i20091119-ai/2026memory/assets/heart.png

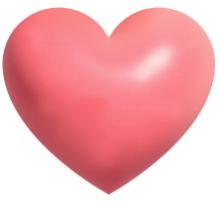
assets/heart.png
