i20091119-ai/2026memory/assets/mascot.png

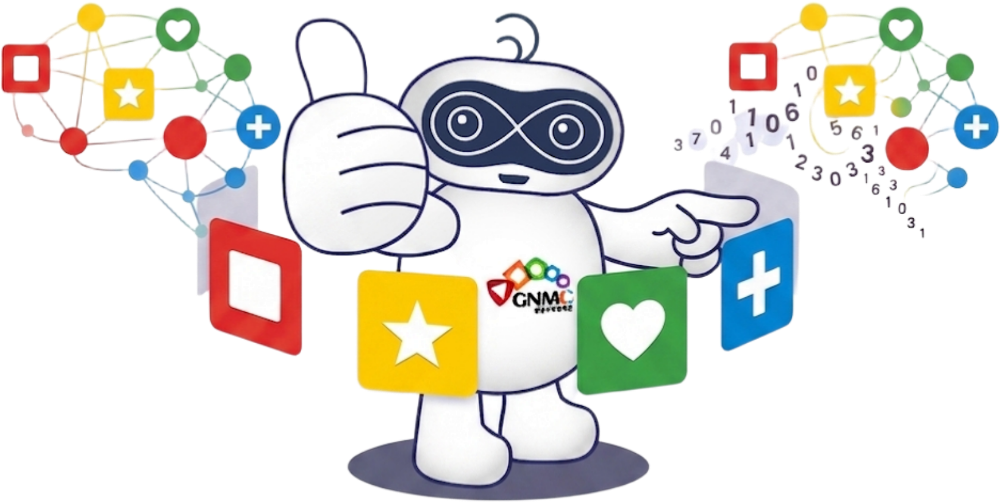
assets/mascot.png
