i20091119-ai/2026memory/README.md

# 토러스와 즐기는 랜덤 메모리 게임

100파이 아케이드 버튼 5개(빨강·노랑·초록·파랑 + 흰색)로 플레이하는 기억력 게임.
정식 게임기는 **라즈베리파이 5 한 대가 책상 2대(모니터 2대)**를 맡고, 두 사람이
흰색 버튼으로 서로 도전해 **2인 대결**을 할 수 있다.
**같은 코드가 일반 브라우저에서 키보드로도 그대로 플레이된다.**

시작할 때 **게임 종류를 버튼 색으로 고른다**:

```
빨강 = 색상  ·  노랑 = 숫자  ·  초록 = 모양  ·  파랑 = 혼합(셋이 섞여 랜덤)
```

한 게임은 **1개 기억 → 2개 → 3개 → 4개**의 4단계이고, **단계마다 5라운드**씩
반복한다 (총 20라운드 = 완주). 목숨은 3개 — 오답이 나오면 하나 줄고 같은
라운드를 **새로운 시퀀스**로 다시 낸다. 목숨이 0이 되면 게임 오버 —
초록 버튼으로 죽은 단계부터 이어하거나, 빨강 버튼으로 다른 게임을 고를 수 있다.

### 2인 대결 (흰색 버튼)

옆 책상에 사람이 있을 때 **흰색 버튼**을 누르면 그쪽 화면에 "도전에 응하시겠습니까?"가
10초 동안 뜬다. 상대가 **흰색을 누르면 수락**, 하던 걸 계속하면(다른 색 버튼을 누를 때마다
남은 시간이 2.5초씩 줄어든다) 그냥 지나간다. 도전은 놀고 있지 않을 때(타이틀·선택·
결과 화면)만 걸 수 있다.

수락하면 둘 다 하던 게임을 멈추고 대결로 들어간다:

- **게임 고르기** — 두 화면에 4색 카드. 먼저 누르는 사람이 정한다 (8초 지나면 혼합).
- **같은 문제가 동시에** 나온다. 먼저 전부 맞힌 사람이 1점. 틀리면 그 라운드는 상대 것,
  둘 다 틀리면 무효. 상대가 몇 개째 맞히는지 내 화면 위에 점으로 보인다.
- 1·1·2·2·3·3·4·4개 기억, 8라운드. **먼저 5점**을 따면 승리. 8라운드 뒤 동점이면 서든데스.
- 어느 쪽이든 빨강+파랑 2초 홀드로 대결을 끝낼 수 있다.

## 바로 해보기

**https://i20091119-ai.github.io/2026memory/** 에서 바로 할 수 있다.

직접 띄우려면:

```bash
python3 -m http.server 8000
# 브라우저에서 http://localhost:8000
```

키보드 **1 2 3 4 5** = 빨강·노랑·초록·파랑·흰색. 화면의 버튼·카드를 마우스나 터치로 직접 눌러도 된다.
`?seats=2` 를 붙이면 화면이 좌우 두 좌석으로 갈리고 오른쪽 좌석은 **Q W E R T** 다 (대결을 혼자 시험해 볼 수 있다).

> 빌드 단계가 없다. 저장소를 그대로 정적 서빙하면 끝이다.
> (파일을 직접 여는 `file://` 방식은 ES 모듈 제약 때문에 동작하지 않는다 — 위 명령을 쓸 것.)

## 조작

| | |
|---|---|
| 게임 고르기 | 선택 화면에서 **그 게임 색의 버튼**을 누른다 (카드가 버튼 색으로 칠해져 있다) |
| 색상 항목 회상 | 외운 색의 **버튼을 직접** 누른다 |
| 숫자·모양 항목 회상 | 4지선다 — 외운 값이 들어 있는 칸의 **색 버튼**을 누른다 |
| 혼합 게임 | 항목마다 위 두 방식이 자동으로 갈린다 |
| 화면 넘기기 | 게임 안내는 **아무 버튼이나 누를 때까지 기다린다** (자동으로 넘어가지 않는다) |
| 옆 사람에게 도전 | **흰색** 버튼 (타이틀·선택·결과 화면에서). 상대도 흰색을 누르면 대결 시작 |
| 홈으로 나가기 | **빨강 + 파랑을 2초 동안 함께** (화면 위쪽에 게이지가 찬다). 브라우저에서는 **ESC** 로도 된다 |
| 운영 기록 보기 | 타이틀에서 **노랑 + 초록을 3초 동안 함께**. 브라우저에서는 **0** 키 (아래 "운영 기록" 참조) |
| 입력 제한시간 | 없음 |

회상 중에는 화면 가운데 **답안 스트립**이 있어, 이번 단계가 몇 개짜리인지와
지금까지 무엇을 눌렀는지를 함께 보여 준다 (예: `4` `5` `7` `_` `_` — "5개 중 4번째").

틀렸을 때는 그 자리에 **내가 누른 값을 그대로** 넣고 빨간 테두리로 크게 흔든다.
정답을 대신 끼워 넣으면 "나는 이걸 눌렀는데 왜 다른 게 들어갔지?" 하는 오해가
생기기 때문이다. 정답이 무엇이었는지는 이어지는 오답 화면에서 따로 크게 보여 준다.

## 운영 기록 (부스 담당자용)

판마다 한 줄씩 **플레이 기록**이 남는다 — 시각, 게임 종류, 어디까지 갔나,
결과(완주/게임오버/중도이탈), 소요 시간, 이어하기·오답 횟수. 개인정보는 없고
기기의 localStorage 안에만 쌓이며 어디로도 보내지 않는다 (`js/playlog.js`).

타이틀에서 **노랑 + 초록을 3초** 누르면 집계 화면이 뜬다.

| 버튼 | |
|---|---|
| 노랑 | 기간 바꾸기 — 이번 달 → 지난 달 → 오늘 → 전체 |
| 초록 | 그 기간의 **CSV 저장** (다운로드 폴더, 엑셀에서 바로 열림) |
| 파랑 두 번 | 기록 전부 지우기 (실수 방지로 5초 안에 두 번) |
| 빨강 | 닫기 (90초 방치해도 닫힌다) |

보이는 것: 플레이 판 수 · 완주 수와 완주율 · 중도 이탈 · 한 판 소요 시간(중간값) ·
게임별 인기와 완주율 · **몇 개 기억까지 갔나**(탈락 곡선) · 시간대별 플레이.
"판"은 사람 수가 아니라 게임을 고른 횟수다 — 한 사람이 두 게임을 하면 2판이다.

키오스크에서 CSV 는 `~/Downloads/torus-log-2026-09.csv` 처럼 떨어지므로
SSH 나 USB 로 꺼내면 된다. 화면을 사진으로 찍어 가도 충분하게 만들어 두었다.

## 개발용 URL 옵션

| 옵션 | 효과 |
|---|---|
| `?game=4&level=3&round=2` | 해당 게임·단계·라운드에서 바로 시작 (1=색상 2=숫자 3=모양 4=혼합) |
| `?fast=1` | 연출 타이밍을 1/3로 단축 (반복 확인용) |
| `?cursor=1` | 마우스 커서를 되살린다 (기본은 키오스크용으로 숨김) |
| `?seats=2` | 두 좌석(책상 2대) 모드. 화면 가로세로비가 2.6 이상이면 저절로 켜진다 |
| `?debug=1` | `window.__torus` 로 좌석·대결 상태를 노출 (자동 검증용) |
| `?bridge=0` | "버튼 미연결" 경고를 끈다 (인코더 구성에서 브리지는 원래 없다) |

프로덕션 키오스크는 파라미터 없는 URL 로 뜨므로 자연히 비활성화된다.

## 테스트

게임 규칙(시퀀스 생성·4지선다 보기 생성·판정·상태 전이)은 `js/games.js` 에
**DOM 무의존 순수 함수**로 분리해 두었다. 그래서 별도 도구 없이 노드 내장 러너로 돌아간다.

```bash
node --test          # 72개 테스트 (게임 규칙 + 대결 규칙 + 모듈 정합성 + 플레이 기록 집계)
```

## 저장소 구조

게임 파일이 저장소 루트에 있다. GitHub Pages 를 루트로 배포하면 주소가 곧 게임이
되고, 하위 폴더 설정이나 리다이렉트가 필요 없다.

```
index.html              # 진입점
style.css
assets/                 # 그림 파일(PNG) — 덮어쓰면 코드 수정 없이 반영된다
├── background.png      #   전 화면 배경
├── mascot.png          #   타이틀 로봇
├── torus-*.png         #   안내 캐릭터 표정 4종
├── logo.png            #   기관 로고
├── favicon.png         #   탭 아이콘
└── heart*.png          #   목숨 하트 3종 (온전 / 깨짐 / 회색)
fonts/                  # 로컬 번들 웹폰트 (CDN 미사용)
js/
├── config.js           # 모든 튜닝 상수 (난이도·타이밍) — 조정은 여기서만
├── strings.js          # 모든 화면 문구 — 문구 수정은 여기서만
├── games.js            # 게임 규칙 순수 함수 (테스트 대상)
├── state.js            # 상태 머신 메인 루프 (좌석 하나의 혼자 놀기)
├── arena.js            # 두 좌석을 묶는 심판 — 도전 신청/수락, 대결 진행
├── versus.js           # 대결 규칙 순수 함수 (테스트 대상)
├── main.js             # 부트스트랩·좌석 생성·키오스크 설정
├── input.js            # KeyboardInput / GamepadInput(인코더) / SocketInput 추상화
├── audio.js            # Web Audio 효과음 합성 (외부 음원 없음)
├── logo.js             # 기관 로고 배치 (모든 화면 공통)
├── mascot.js           # 타이틀 로봇 캐릭터
├── torus.js            # 게임 중 안내 캐릭터 + 표정 4종
├── shapes.js           # 3차 도형 8종 SVG
├── storage.js          # 게임별 완주 횟수 저장/로드
├── playlog.js          # 플레이 기록(판마다 한 줄) + 집계·CSV — 운영자 화면의 재료
├── util.js             # DOM·대기 도우미 (중도 이탈 신호 포함)
└── scenes/             # title, select(게임 선택), intro, present, recall,
                        #   feedback, gameover, allclear, attract, admin(운영 기록),
                        #   versus(도전 프롬프트·대결 화면), hud, strip
firmware/button_bridge/ # 우노 Q 버튼 → WebSocket 브리지
├── sketch/sketch.ino   # STM32: 버튼 읽기 + 디바운스
└── python/main.py      # 리눅스: WebSocket 서버
scripts/                # 실물 게임기 설치용 (우노 Q 리눅스에서 실행)
├── survey.sh           # 부팅 시 켜지는 것 훑어보기 (읽기 전용)
├── disable-autostart.sh#   그중 하나만 끄기 / 되돌리기
├── install-kiosk.sh    # 게임 설치 + 자동시작 등록 (파이/우노 Q 자동 감지)
├── pi-kiosk.sh         # 라즈베리파이: 모니터 2대 배치·소리·3840×1080 창 띄우기
├── bridge-watch.sh     # (우노 Q) 버튼 브리지가 죽으면 진단·자동 복구
└── start-all.sh        # (우노 Q) 서버+브리지+전체화면 한 번에 띄우기
docs/assets.html        # 에셋 시트 (새로 그릴 그림 목록·규격)
docs/에셋시트.pdf        # 위 문서를 인쇄용으로 뽑은 것
docs/wiring.html        # 배선도 (조립용)
docs/배선도.pdf          # 위 문서를 인쇄용으로 뽑은 것
docs/hardware-guide.md  # 실물 조립·설치 가이드 (배선·전원·문제 해결)
docs/raspberry-pi-setup.md # 정식 게임기: 라즈베리파이 5 설치 절차
docs/buttontest.html    # 인코더 배선 확인 페이지 (누른 버튼에 불) — 파이에서 /docs/buttontest.html
docs/assembly.html      # 벤치 조립 가이드 (파이 단자·1차 연결·전체 연결·버튼/LED 배선 그림)
docs/조립가이드.pdf      # 위 문서 A4 가로 2장
docs/powerbutton.html   # 해설사용 전원 버튼 배선 (파이 5 J2)
docs/전원버튼배선.pdf    # 위 문서 A4 가로 1장
docs/labels.html        # 책상에 붙이는 버튼 안내 라벨 (흰 버튼=도전, 빨+파 2초=처음으로)
docs/버튼안내라벨.pdf    # 위 문서 A4 1장 (책상 2대분)
docs/desk.html          # 정식 게임기 책상 제작 도면 (치수·부재표·가공 체크리스트·겨냥도·배선도)
docs/책상도면.pdf        # 위 문서를 인쇄용으로 뽑은 것 (목공 사장님용)
docs/intro.html         # 한 장짜리 게임 소개 (실제 화면 캡처 docs/intro/*.png)
docs/게임소개.pdf        # 위 문서를 A4 가로 1장으로 뽑은 것
test/games.test.js      # node --test
```

설계명세서 §2 는 `web/` 하위에 두도록 되어 있으나, GitHub Pages 를 루트로 배포해도 바로 열리도록 저장소 루트로 옮겼다. 파일 구성 자체는 그대로다. 또 §2 목록에 더해 `shapes.js`(도형 SVG)와 `util.js`(공통 도우미),
`scenes/hud.js`·`scenes/attract.js` 를 두었다. 역할 분리를 위한 것으로 의존성은 늘지 않았다.

## 기술 스택

순수 HTML + CSS + ES 모듈 JavaScript. **빌드 도구·번들러·npm 의존성이 없다.**
외부 라이브러리도 CDN 링크도 쓰지 않아 오프라인 키오스크에서 완전히 동작한다.

- 렌더링: DOM + CSS 애니메이션, 필요한 곳만 인라인 SVG
- 저장: localStorage — 게임별 완주 횟수(`torus-memory.clears.v2`)와
  플레이 기록(`torus-memory.log.v1`, 최대 5,000줄). 하이스코어는 없다 —
  부스라 매번 다른 사람이 오고 게임에 끝이 있어 의미가 없다.
  접근이 막힌 환경에서도 게임은 정상 진행
- 사운드: Web Audio 합성 효과음만 (배경음악 없음, 음원 파일 없음)

### 폰트

두 벌을 `fonts/` 에 동봉해 쓴다. 둘 다 **SIL Open Font License 1.1** 이라 재배포가 허용된다.

| 쓰임 | 서체 | 파일 | 라이선스 |
|---|---|---|---|
| 제목·큰 글씨 | **Do Hyeon** (배민 도현체) | `DoHyeon-Regular.woff2` (200KB) | `OFL-DoHyeon.txt` |
| 말풍선·안내 문구 등 나머지 | **Jua** (주아체) | `Jua-Regular.woff2` (360KB) | `OFL-Jua.txt` |

출처: [google/fonts](https://github.com/google/fonts) — 원본 TTF 를 woff2 로 변환해 넣었다.

메이플스토리체처럼 둥글고 귀여운 느낌을 원했으나, 그 서체는 저장소 동봉(재배포)
조건을 확인할 수 없어 쓰지 않았다. 키오스크가 오프라인이라 폰트는 반드시 동봉해야
하므로, 재배포가 명확히 허용된 OFL 서체 중 가장 가까운 **주아체**를 골랐다.
바꾸려면 `fonts/` 에 woff2 를 넣고 `style.css` 의 `@font-face` 와 `--body` 만 고치면 된다.

## 그림 교체 (에셋)

새로 그릴 수 있는 그림의 목록·규격·주의사항은 **[`docs/에셋시트.pdf`](docs/에셋시트.pdf)** 에 정리해 두었다.
(원본은 `docs/assets.html` 이며, 브라우저로 열어 인쇄하면 PDF 가 다시 나온다 — 그림이
실제 게임 코드에서 렌더링되므로 항상 현재 상태와 일치한다.)

그림은 전부 `assets/` 의 **PNG 파일**이다. 같은 이름으로 덮어쓰면 코드 수정 없이 반영된다.
(도형 8종만 예외로 `js/shapes.js` 안에 SVG 로 들어 있고, 이건 확정이다.)

캐릭터·로고 크기는 px 로 고정하지 않고 **화면 높이에 맞춰** 정해진다
(`style.css` 의 `--char-h`, `--brand-h`). 낮은 화면에서도 서로 겹치지 않게 하기 위함이다.

## 실물 게임기

**정식 게임기(라즈베리파이 5 + USB 인코더, 책상 2대)** 설치는
[`docs/raspberry-pi-setup.md`](docs/raspberry-pi-setup.md) 를 따른다. 브리지·감시 스크립트 없이
`install-kiosk.sh` 한 번이면 된다. 책상(800×600×700 원목, 등판에 27" 모니터·스피커·제어부)
제작 도면은 **[`docs/책상도면.pdf`](docs/책상도면.pdf)** (원본 `docs/desk.html`).

파일럿 구성(우노 Q + App Lab 브리지)은 그대로 지원한다. 배선 그림은
**[`docs/배선도.pdf`](docs/배선도.pdf)**, 조립·키오스크 설정은
[`docs/hardware-guide.md`](docs/hardware-guide.md), 버튼 브리지는
[`firmware/README.md`](firmware/README.md) 참조.

우노 Q 리눅스에서 설치는 스크립트 세 줄이면 끝난다.

```bash
bash scripts/survey.sh morse          # 예전 앱이 어디에 걸려 있는지 (읽기만 함)
bash scripts/disable-autostart.sh …   # 그것만 끄기 (--restore 로 되돌림)
bash scripts/install-kiosk.sh         # 게임 설치 + 부팅 자동시작
```

웹앱은 시작할 때 `ws://localhost:8765` 접속을 시도하고, 실패하면 **조용히 키보드 모드로만
동작한다**(에러 화면이 뜨지 않는다). 접속 여부는 화면 **왼쪽 위 점**으로 표시된다 —
초록이면 연결됨, 회색이면 미연결. 실물 키오스크(localhost)에서 끊긴 동안에는
점이 빨갛게 바뀌고 **"버튼 미연결"** 글자까지 함께 뜬다.

부스 운영 중에 **게임은 멀쩡한데 아케이드 버튼만 조용히 죽는** 고장을 겪었다
(App Lab 의 브리지 앱이 멈춘 것이고, App Lab 은 멈춘 앱을 되살리지 않는다).
그래서 `install-kiosk.sh` 가 감시 서비스를 함께 등록한다 — 30초마다 8765 를
확인해서 닫혀 있으면 브리지를 다시 띄우고, 죽은 시각을
`~/torus-bridge-watch.log` 에 남긴다.

```bash
bash scripts/bridge-watch.sh --once      # 버튼이 안 먹을 때 한 줄 진단
bash scripts/bridge-watch.sh --restart   # 지금 당장 되살리기
```

## GitHub Pages 배포

저장소 **Settings → Pages** 에서

- Source: `Deploy from a branch`
- Branch: 배포할 브랜치 + 폴더 **`/`(root)**

로 지정하면 끝이다. 게임이 저장소 루트에 있으므로 주소가 곧 게임이 된다.

> 게임 파일을 하위 폴더(예전의 `web/`)에 두면, Pages 폴더 설정을 그 폴더로
> 정확히 맞추지 않는 한 루트에 `index.html` 이 없어 GitHub 이 `README.md` 를
> 대신 렌더링한다 — 게임 대신 이 문서가 뜬다. 그 함정을 없애려고 루트에 두었다.

빌드 단계가 없으므로 워크플로 설정은 필요 없다.
`.nojekyll` 은 Pages 가 파일을 Jekyll 로 가공하지 않고 그대로 서빙하게 한다.
