i20091119-ai/2026memory/docs/버튼안내라벨.pdf

## 버튼 안내 라벨 — 책상 2대분 (점선 따라 자르기)

코팅(라미네이팅)해서 양면테이프로 붙이거나, 투명 아크릴 명패에 끼운다. 도전 라벨은 흰 버튼 바로 옆 상판, 처음으로 라벨은 스커트 앞판 가운데(그릴 사이)에.

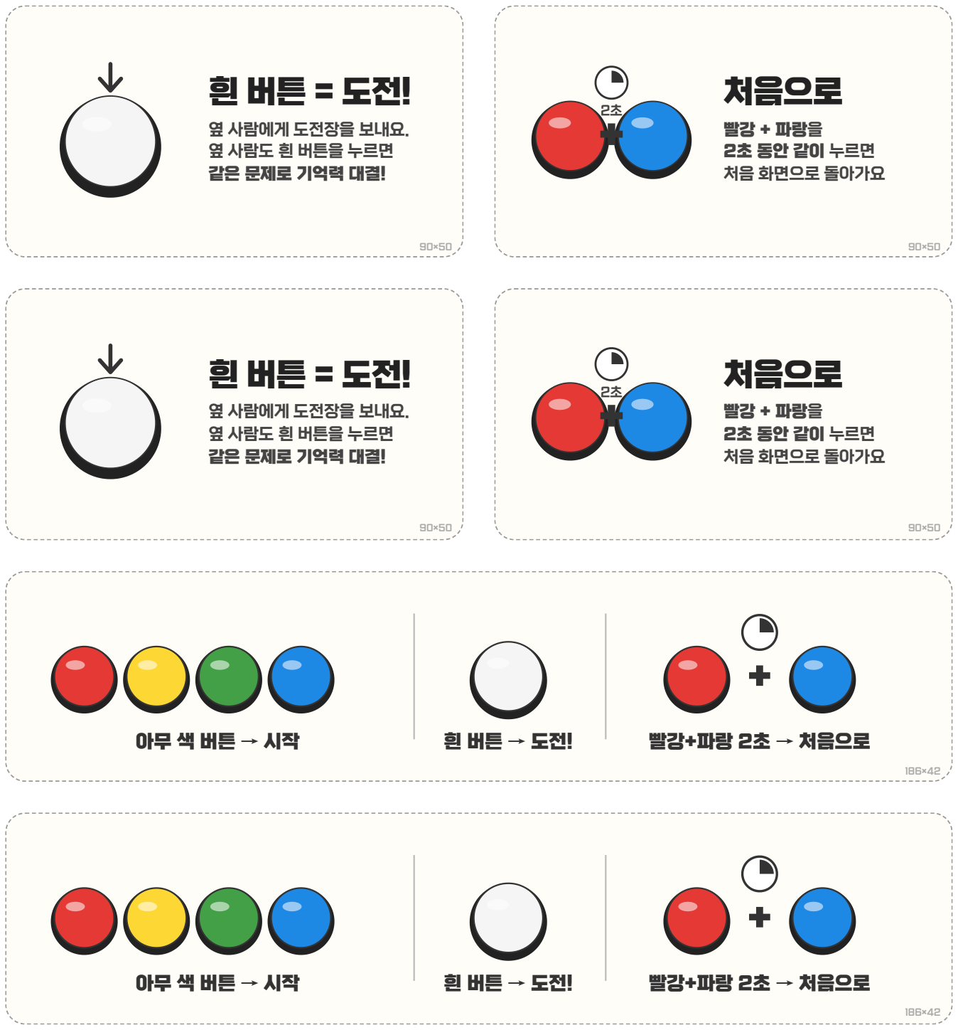
[picture p8: figure]
옆 사람에게 도전장을 보내요. 옆 사람도 흰 버튼을 누르면 같은 문제로 기억력 대결!; 처음으로; 빨강 + 파랑을 2초 동안 같이 누르면 처음 화면으로 돌아가요; 빨강+파랑 2초 → 처음으로

위치 제안 — ① "도전" 라벨: 흰 버튼 옆, 글자가 버튼을 가리키게. ② "처음으로" 라벨: 앞판 가운데 또는 빨강·파랑 사이 상판 앞쪽 가장자리. ③ 긴 라벨은 둘을 합친 것으로, 상판 앞 가장자리에 하나로 붙여도 된다 (그러면 ①②는 생략).
같은 내용이 게임 타이틀 화면 아래에도 그림으로 떠 있으니, 라벨은 화면을 안 볼 때를 위한 보조다.
