i20091119-ai/2026memory/assets/background.png

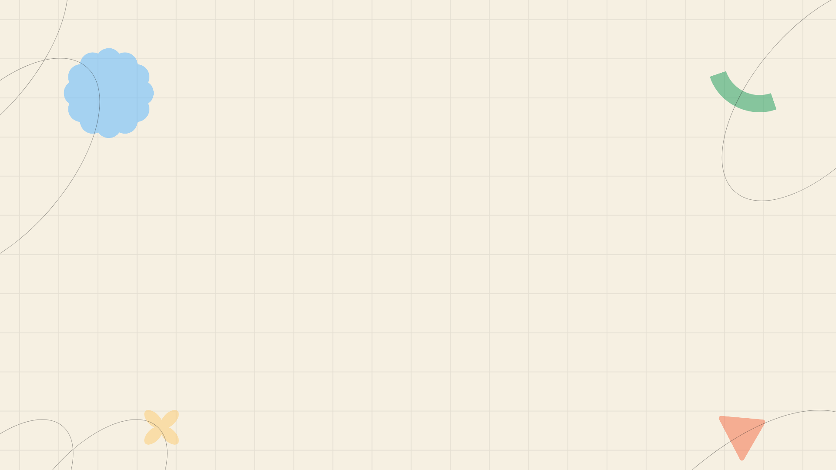
assets/background.png
