i20091119-ai/2026memory/assets/heart-broken.png

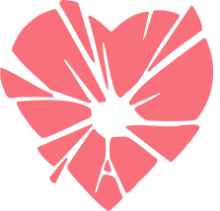
assets/heart-broken.png
