i20091119-ai/2026memory/assets/heart-off.png

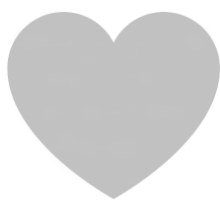
assets/heart-off.png
