i20091119-ai/2026memory/assets/torus-cheer.png

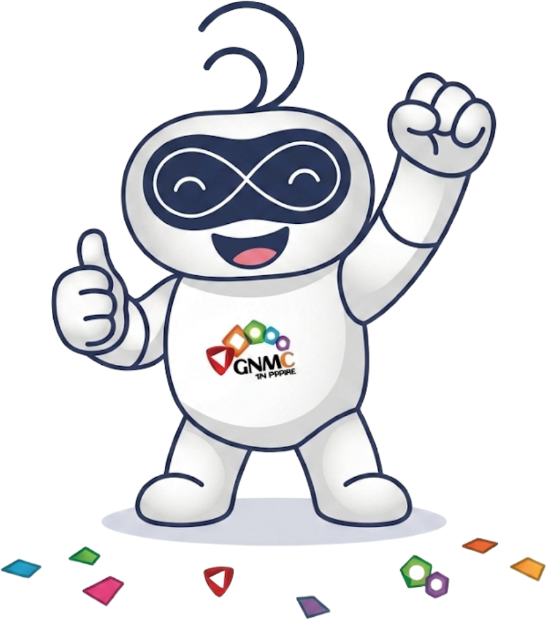
assets/torus-cheer.png
