i20091119-ai/2026memory/assets/torus-idle.png

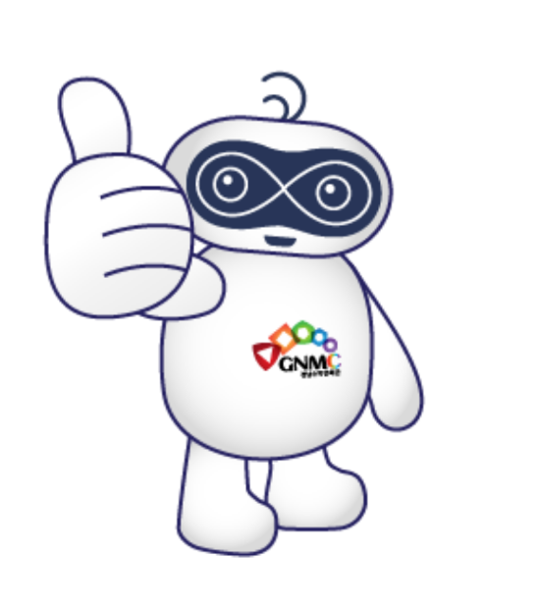
assets/torus-idle.png
