i20091119-ai/2026memory/assets/torus-sad.png

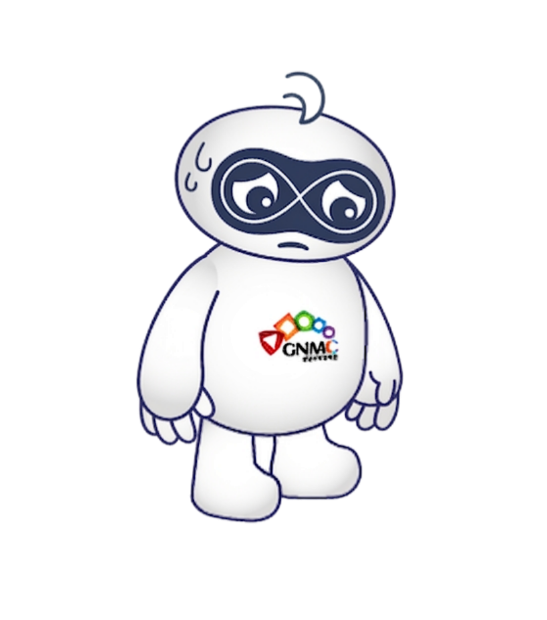
assets/torus-sad.png
