i20091119-ai/2026memory/assets/torus-talk.png

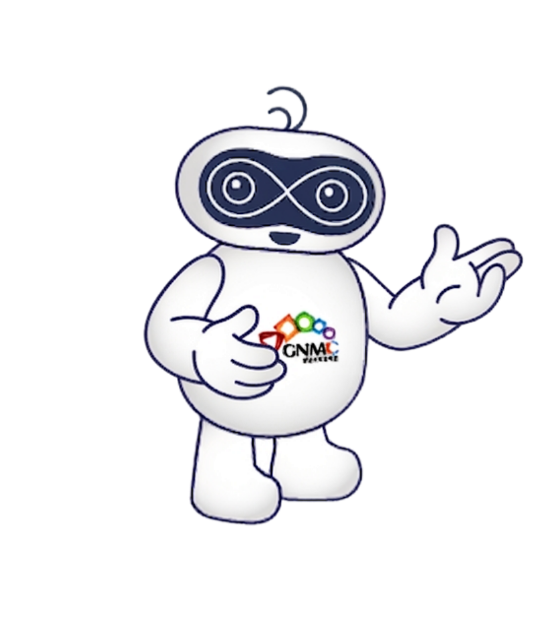
assets/torus-talk.png
