i20091119-ai/2026memory/docs/intro/allclear.png

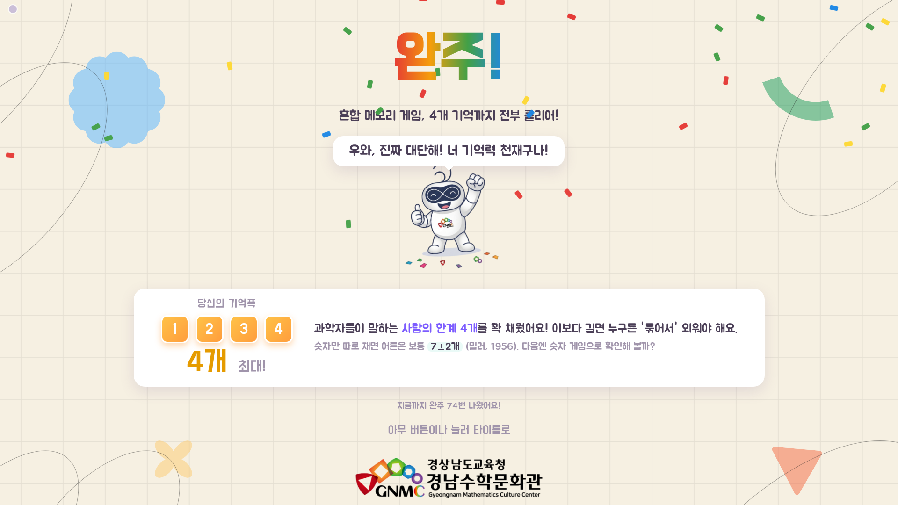
docs/intro/allclear.png
