i20091119-ai/2026memory/docs/intro/present.png

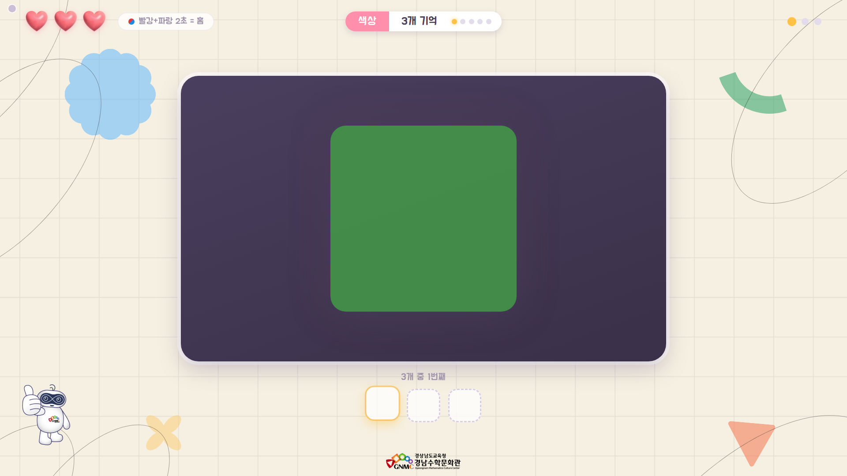
docs/intro/present.png
