i20091119-ai/2026memory/docs/intro/recall.png

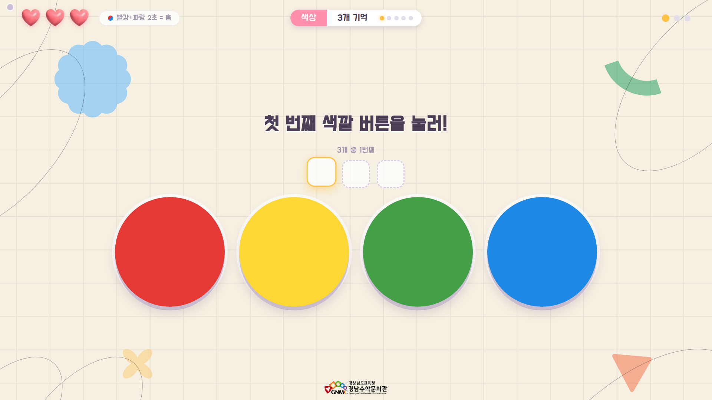
docs/intro/recall.png
