i20091119-ai/2026memory/docs/intro/select.png

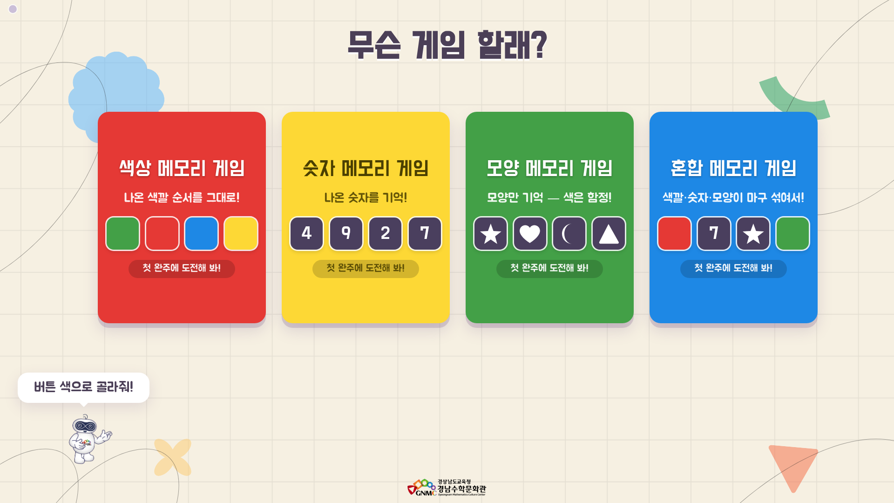
docs/intro/select.png
