i20091119-ai/2026memory/docs/intro/vs-challenge.png

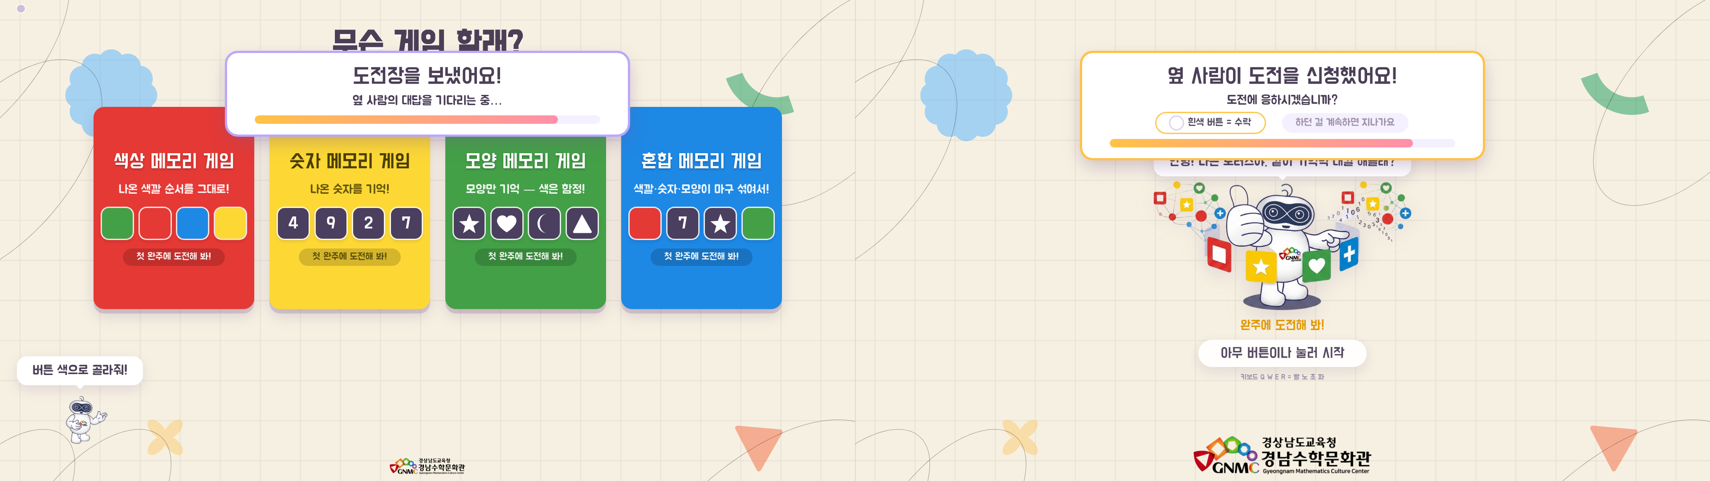
docs/intro/vs-challenge.png
