i20091119-ai/2026memory/(commit log)

2026-08-04 토러스와 즐기는 랜덤 메모리 게임 v1.1 구현
    설계명세서 v1.1 전체를 구현했다. 색깔(1차) → 숫자(2차) → 모양(3차)을
    차수당 5단계씩 자동 진행하는 코스형 기억력 게임으로, 4개의 아케이드 버튼
    또는 키보드 1·2·3·4 로 플레이한다.
    주요 구성
    - web/js/games.js: 시퀀스 생성·4지선다 보기 생성·판정·상태 전이를 DOM 무의존
    순수 함수로 분리. node --test 로 검증한다.
    - web/js/state.js: 명세서 §3.1 상태 머신 (목숨 3개 코스 공유, 오답 시 같은
    단계를 새 시퀀스로 재출제, 컨티뉴, 중도 이탈)
    - web/js/input.js: KeyboardInput / SocketInput 을 같은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
2026-08-04 Pages 를 저장소 루트로 배포해도 게임이 열리게 한다
    Pages 폴더를 /web 이 아닌 / 로 지정하면 루트에 index.html 이 없어
    GitHub 이 README.md 를 대신 렌더링한다 — 게임 대신 설명서가 뜬다.
    루트에 web/ 로 넘겨주는 리다이렉트 페이지를 두어 어느 폴더 설정에서도
    게임이 열리게 했다. 폴더를 /web 으로 지정하면 이 파일은 배포되지 않으므로
    영향이 없다. .nojekyll 로 Jekyll 가공 없이 그대로 서빙되게 했다.
    Claude-Session: https://claude.ai/code/session_01EKXYb7k7QXk6KPT26SBzSF
2026-08-04 게임을 저장소 루트로 옮겨 주소가 곧 게임이 되게 한다
    web/ 하위에 두면 Pages 폴더 설정을 /web 으로 정확히 맞추지 않는 한 루트에
    index.html 이 없어 GitHub 이 README.md 를 대신 렌더링한다. 리다이렉트로
    우회했지만 한 번 더 튕기는 것보다 애초에 루트에 두는 편이 낫다.
    web/ 의 내용을 저장소 루트로 옮기고 리다이렉트 페이지를 없앴다.
    테스트 임포트 경로, systemd 서빙 경로, 문서를 함께 맞췄다.
    파일 구성과 코드는 그대로이며 설계명세서 §2 대비 위치만 달라졌다.
    Claude-Session: https://claud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
2026-08-04 차수 안내를 버튼으로 넘기고, 답안 스트립과 화사한 테마를 넣는다
    - 차수 안내가 2.5초 만에 자동으로 지나가 규칙을 놓치는 문제. 이제 아무
    버튼이나 누를 때까지 기다린다. 직전 입력이 튀어 곧바로 넘어가지 않도록
    처음 INTRO_MIN_MS 동안은 입력을 무시하고, 그 뒤에 안내를 띄운다.
    - 홈으로 나가는 방법(빨강+파랑 2초)을 HUD 에 상시 표시하고, 홀드 게이지에
    "홈으로 돌아가는 중" 문구를 붙였다. 브라우저에서는 ESC 로도 나갈 수 있다.
    실기에는 ESC 가 없으므로 홀드 콤보가 여전히 정식 경로다.
    - 답안 스트립을 새로 만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
2026-08-04 타이틀 캐릭터를 로봇 마스코트로 바꾼다
    발주자가 준 캐릭터 시안(흰 몸통 + 남색 바이저 + 엄지척)을 인라인 SVG 로
    옮겨 타이틀 화면에 세웠다. 시안처럼 빨 네모·노 별·초 하트·파 십자 카드를
    부채꼴로 펼쳐 함께 배치했다.
    이미지 파일 대신 SVG 로 그린 이유: 오프라인 키오스크에서 해상도와 무관하게
    선명해야 하고, 저장소에 바이너리를 늘리지 않기 위해서다.
    게임 중 안내자(토러스)는 그대로 두었다 — 요청 범위가 메인 표지였다.
    Claude-Session: https://claude.ai/code/session_01EKXYb7k7QXk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
2026-08-04 차수 배지·기관 로고·에셋 시트를 넣는다
    - HUD 의 "1차 2단계"가 맨 글자라 밋밋했다. 두 칸짜리 배지(글상자)로 감싸고
    왼쪽 칸 색을 차수마다 다르게 했다 — 지금 어느 게임인지 색으로도 구분된다.
    - 기관 로고를 오버레이에 붙여 모든 화면에 항상 보이게 했다. 게임 중에는
    오른쪽 아래 작게, 타이틀·올클리어에서는 아래 가운데 크게 나온다.
    로고 크기 전환은 :has() 로 처리해 씬마다 코드를 넣지 않아도 된다.
    접속 상태 점은 로고 자리를 비켜 왼쪽 위로 옮겼다.
    assets/logo.svg 는 공식 로고 원본을 받기 전까지 쓰는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
2026-08-04 토러스 표정에서 celebrate 를 없애고 cheer 로 합친다
    cheer(단계 클리어)와 celebrate(올클리어)는 눈·입·팔·몸 애니메이션이 완전히
    같았고, 차이는 스프링클이 반짝이는 것뿐이었다. 표정이 아니라 장식 효과라
    따로 그릴 이유가 없다 — 그림을 새로 그릴 때 헛일이 된다.
    기쁜 표정은 cheer 하나로 합치고, 올클리어의 '더 요란한' 느낌은
    씬 선택자(.scene-allclear .torus)로 옮겼다. 화면상 결과는 그대로다.
    MOODS 를 export 해서 표정이 다시 늘어나지 않는지 테스트로 잡는다.
    에셋 시트도 표정 4종으로 갱신했다.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
2026-08-04 에셋 시트에 파일 이름 규칙을 추가한다
    새로 그린 그림을 넘겨받을 때 어느 파일이 어느 그림인지 헷갈리지 않도록,
    코드에서 쓰는 키와 같은 이름을 쓰기로 하고 표로 정리했다.
    도형 8개는 js/config.js 의 SHAPES 목록과 글자까지 같아야 하며, 어긋나면
    정합성 테스트가 잡아낸다.
    쪽이 늘어나 고정 쪽번호(N / 4)가 틀리게 되어 없앴다.
    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
2026-08-04 에셋 시트에서 도형 8종을 확정으로 표시한다
    도형은 지금 것으로 간다는 결정을 문서에 반영했다. 전체 목록에 '상태' 열을
    넣어 새로 그릴 것과 유지할 것을 구분하고, 파일 이름 표에서도 도형은
    넘길 파일이 없다고 못 박았다. 그리는 사람이 헛일하지 않게 하는 게 목적이다.
    규격 자체는 남겨 뒀다 — 나중에 바꿀 일이 생기면 그때 필요하다.
    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
2026-08-04 배경과 목숨 하트를 그림 파일로 빼고, 배경 디자인 요구서를 넣는다
    배경이 CSS 그라데이션이라 그림 파일을 받을 자리가 없었다. assets/background.svg
    한 장으로 옮기고 body 가 cover 로 깔도록 바꿨다 — 파일만 덮어쓰면 배경이 바뀐다.
    장식 방울도 CSS 가상요소에서 그림 안으로 옮겨, 배경은 이 파일 하나가 전부가 된다.
    하트도 글자(♥)라 서체에 따라 모양이 달라지고 그림으로 교체할 수 없었다.
    heart / heart-broken / heart-off 세 장으로 바꿔, 목숨을 잃는 순간에는 깨진 하트가
    잠깐 보였다가 회색으로 확정된다.
    에셋 시트에 배경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
2026-08-04 그림을 PNG 파일로 받을 수 있게 바꾼다
    캐릭터 두 개가 코드 안에 SVG 로 박혀 있어서 그린 PNG 를 넣을 자리가 없었다.
    mascot.js / torus.js 를 <img> 기반으로 바꾸고, 안내 캐릭터는 표정마다 그림
    한 장씩(4장)을 쓰게 했다. 로고·하트·배경도 PNG 로 통일했다.
    지금 있는 임시 그림을 그대로 PNG(투명 배경)로 뽑아 넣어 뒀으므로, 실제 그림이
    오면 같은 이름으로 덮어쓰기만 하면 된다.
    그림 경로는 import.meta.url 기준으로 풀었다. 문서(docs/assets.html)처럼 다른
    깊이의 페이지에서 모듈을 불러도 경로가 깨지지 않는다.
    에셋 시트를 PNG 기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
2026-08-04 올려준 그림 파일을 반영한다
    파일명 오타를 고쳤다: herat-broken.png → heart-broken.png. 그대로 두면 깨진
    하트만 임시 그림이 나온다.
    전부 1920×1080 캔버스에 그려져 있어 화면에서 캐릭터가 아주 작게 나왔다.
    코드가 가로폭 기준으로 크기를 맞추는데, 그림 대부분이 투명 여백이라
    캐릭터가 실제로는 1/3 크기로 그려진 탓이다. 투명 여백을 잘라내고 권장
    크기로 줄였다 — 그림 자체는 손대지 않았고 여백만 없앴다.
    표정 4종과 하트 3종은 각각 '공통 여백'으로 잘라, 전환할 때 캐릭터가
    튀지 않게 했다. 전체 용량은 3.7MB → 1.7MB.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
2026-08-04 화면 비율에 따라 잘리거나 겹치던 문제를 고친다
    캐릭터 크기를 px 로 고정해 두어서, 화면이 낮으면 내용이 세로로 넘쳐 위가
    잘리고 요소끼리 겹쳤다. 크기를 화면 높이(vh) 기준으로 바꾸고 씬마다 상한을
    따로 뒀다. JS 의 인라인 px 지정을 없애 CSS 가 크기를 온전히 맡는다.
    말풍선이 캐릭터에 가려지던 것을 고쳤다(z-index). 캐릭터가 손을 들면
    말풍선 위를 덮었다.
    로고를 오른쪽 아래에서 아래 가운데로 옮겼다. 배경 그림은 네 모서리에 장식이
    있고 아래 가운데가 비어 있어, 거기가 유일하게 깨끗한 자리다. 로고 높이를
    -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
2026-08-05 코드 주석의 그림 규격을 실제와 맞춘다
    mascot.js / torus.js 주석이 '정사각 800×800' 을 권장한다고 남아 있었다.
    실제로는 캐릭터에 맞게 잘라 주면 되고, 크기는 화면 높이에 맞춰 정해진다.
    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
2026-08-05 본문 서체를 주아체로 바꾸고 작은 요소들을 키운다
    말풍선을 비롯한 본문 글씨가 시스템 기본 서체라 딱딱했다. 둥글고 귀여운
    주아체(Jua)로 바꿨다. 제목은 그대로 도현체를 쓴다.
    메이플스토리체를 쓰지 않은 이유: 키오스크가 오프라인이라 폰트를 저장소에
    동봉해야 하는데 재배포 조건을 확인할 수 없었다. 재배포가 명확히 허용된
    OFL 서체 5종을 실제 문구로 비교해 가장 가까운 주아체를 골랐다.
    손글씨 계열(동글·개구·감자꽃·하이멜로디)은 작은 글씨에서 읽기 어려웠다.
    작아서 눈에 안 들어오던 것들을 키웠다 —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
2026-08-05 오답·목숨 연출을 눈에 보이게 고침
    하트 깨짐:
    - 그림 하트로 바꾼 뒤 연출이 700ms 스케일 변화뿐이라 알아보기 어려웠다.
    1500ms 3박자(쿵 → 흔들 → 툭)로 늘리고, 화면이 뜨는 것과 겹치지 않게
    220ms 뜸을 들인 뒤 시작한다.
    - 밝기 번쩍임은 크림색 배경에서 하얗게 날아가 오히려 안 보여서, 붉은
    빛무리(drop-shadow)로 대신했다.
    - 애니메이션이 끝나도 회색으로 되돌리지 않고 깨진 하트를 그대로 남긴다.
    오답 화면이 끝나고 HUD 가 새로 그려질 때 자연히 회색이 된다.
    - 연출이 다 들어가도록 MISS_MS 1200 → 2100.
    답안 스트립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
2026-08-05 카운트다운을 셋·둘·하나로 바꿔 문제와 구분되게 함
    2차(숫자)에서 3·2·1 을 흰색 아라비아 숫자로 크게 띄우니 외워야 할 숫자와
    생김새가 똑같아서, 이게 카운트인지 문제인지 헷갈린다는 지적이 있었다.
    네 가지를 한꺼번에 다르게 두어 겹칠 여지를 없앴다.
    - 글자: 아라비아 숫자 → 한글 (셋·둘·하나). 끝은 '준비!' 대신 '시작!'
    - 색 : 흰색 → 노란색 (외울 숫자는 흰색 그대로)
    - 모양: 남은 시간이 줄어드는 원형 게이지 링 안에 넣어 타이머로 보이게.
    링이 도는 시간은 COUNTDOWN_MS 를 그대로 받아 항상 한 칸에 한 바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
2026-08-05 우노 Q 설치 스크립트 추가 (기존 앱 정리 포함)
    보드에 올릴 때 손으로 systemd 유닛을 적어 넣던 절차를 스크립트로 만들었다.
    예전에 올린 다른 앱(모스부호)이 부팅과 함께 켜지고 있어서, 그것만 정확히
    떼어 내는 도구가 먼저 필요했다.
    scripts/survey.sh
    부팅 시 켜지는 것을 전부 훑어 보여 준다. 아무것도 고치지 않는다.
    systemd 시스템/사용자 서비스, .desktop 자동시작, crontab @reboot,
    rc.local·프로필, App Lab 앱 디렉터리, 화면 세션 상태까지 한 번에 본다.
    자동 실행 경로가 여러 갈래라, 어디에 걸렸는지 모르고 지우면 엉뚱한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
2026-08-05 조립용 배선도 추가
    지금까지 배선 정보가 hardware-guide.md 의 표로만 있어서, 함체 앞에서 실제로
    선을 물릴 때 참고하기 어려웠다. 인쇄해서 옆에 두고 볼 그림을 만들었다.
    docs/wiring.html → docs/배선도.pdf (A4 2장)
    1쪽 버튼 스위치 → 우노 Q (D2~D5 + GND 데이지체인), 배선표,
    마이크로스위치 COM/NO/NC 구분
    2쪽 LED 12V 병렬 회로, 전원·영상 계통, 신호 흐름, 조립 순서 체크리스트,
    배선 확인 절차, 증상별 점검표
    회로도 관례대로 점(●)이 찍힌 곳만 전기적 연결이고 그냥 교차하는 선은
    이어지지 않는다는 것을 두 그림 모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
2026-08-05 배선도를 실물 부품에 맞춰 보완
    실제 도착한 부품을 보고 문서와 다른 점을 고쳤다.
    - 스위치(BLEE)에 COM①·NC②·NO③ 이 각인되어 있다. 도통 확인 없이 글자만 보고
    물리면 되므로 조립 순서를 그렇게 바꿨다. 각인 없는 스위치를 쓸 경우의
    확인법은 남겨 두었다.
    - "스페이드 단자로 무납땜" 한 가지만 적어 두었던 것을 압착·납땜 두 방법으로
    넓혔다. 납땜은 3초 안에 끝내야 스위치 내부가 안 녹는다는 것,
    어느 쪽이든 수축튜브로 절연해야 NC② 에 닿지 않는다는 것을 명시했다.
    - LED 저항 필요 여부를 판단하는 절을 새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
2026-08-06 App Lab 앱 파일 추가 (실제 보드에서 확인한 형식)
    우노 Q 에 스케치를 올리려니 App Lab 이 firmware/button_bridge 를 앱으로
    인식하지 못했다. 같은 보드에서 돌던 앱의 형식을 확인해 그대로 맞췄다.
    - app.yaml — name/description/icon/version + ports(정수 리스트) + bricks
    - sketch/sketch.yaml — FQBN arduino:zephyr:unoq, 플랫폼 arduino:zephyr,
    Bridge RPC 용 라이브러리 4종. 지금 스케치는 시리얼 방식이라 안 쓰지만
    USE_BRIDGE 를 1 로 바꿀 때 필요하므로 남겨 둔다.
    브리지 바인드 주소를 --host / TORUS_BRIDGE_HOST 로 고를 수 있게 했다.
    App Lab 은 파이썬을 컨테이너에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
2026-08-06 브리지 입력 소스와 바인드 주소를 자동으로 고르게 함
    실물 우노 Q 에서 확인한 사실을 반영했다. 이 보드는 STM32 가 내장이라
    USB 시리얼(/dev/ttyACM*)로 잡히지 않는다 — 실제로 ttyS0~S3 만 있고
    그건 STM32 와 무관하다. 기본값이던 시리얼 방식은 이 보드에서 쓸 수 없다.
    같은 보드에서 돌던 앱을 보니 통신은 App Lab Bridge RPC 로만 이뤄지고 있었다.
    Bridge.provide(이름, 콜백) 으로 MCU 의 통지를 받는 구조로, 저장소의
    run_bridge() 가 이미 쓰고 있던 방식과 같다. 다만 arduino.app_utils 는
    App Lab 런타임 안에서만 임포트되므로, 브리지는 App Lab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
2026-08-06 스케치를 실물에서 확인한 Bridge API 로 맞춤
    같은 보드에서 돌던 앱의 스케치를 확인해 추측으로 적어 두었던 부분을 고쳤다.
    - 헤더가 <Bridge.h> 가 아니라 <Arduino_RouterBridge.h> 다. 플랫폼
    (arduino:zephyr)에 들어 있어 sketch.yaml 의 libraries 에는 안 적는다.
    - loop() 에 Bridge.update() 가 필요하다. 이게 빠지면 RPC 가 돌지 않는다.
    - USE_BRIDGE 기본값을 1 로 바꿨다. 우노 Q 는 STM32 가 내장이라 USB 시리얼로
    잡히지 않아 Bridge 말고는 통로가 없다. 시리얼 경로는 다른 보드용으로 남겼다.
    install-kiosk.sh 는 USB 시리얼 장치가 없으면 브리지 서비스를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
2026-08-06 버튼 이벤트를 로그에 남겨 배선 확인이 되게 함
    App Lab 로그만 보고는 브리지가 버튼을 받고 있는지 알 수 없었다. 설치 직후
    "왼쪽부터 눌러서 0→1→2→3 이 찍히는지" 확인하는 게 배선 검증의 핵심인데
    그걸 볼 방법이 없었다.
    처음 12번은 INFO 로 남기고 그 뒤로는 DEBUG 로 내린다. 설치 확인은 되면서
    상시 운영 중에 로그가 쌓이지는 않는다. -v 를 붙이면 계속 다 보인다.
    색 이름을 함께 찍어 배선이 뒤바뀐 경우를 바로 알아볼 수 있게 했다.
    Claude-Session: https://claude.ai/code/session_01EKXYb7k7Q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
2026-08-06 start-all.sh 도 브리지 중복 실행을 피하게 함
    우노 Q 에서는 브리지가 App Lab 앱으로 8765 를 이미 잡고 있다. 그 상태에서
    start-all.sh 가 브리지를 또 띄우면 포트가 충돌한다. install-kiosk.sh 에 넣은
    것과 같은 판단을 여기에도 넣었다.
    - 8765 가 이미 열려 있으면 그대로 두고 넘어간다
    - USB 시리얼 장치가 없으면 App Lab 으로 안내하고 건너뛴다
    - 있으면 찾은 장치 이름을 그대로 쓴다 (/dev/ttyACM0 고정을 없앴다)
    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
2026-08-06 키오스크가 부팅 시 안 뜨던 문제 수정
    재부팅했더니 웹서버·브리지는 뜨는데 크로미움만 안 떴다. 원인은 키오스크
    등록 방식을 고르는 판단이 틀렸던 것이다.
    graphical-session.target 은 어느 배포판에나 유닛 파일이 있어서, 파일 존재만
    확인하면 항상 "서비스로 걸 수 있다"고 판단해 버린다. 하지만 세션 관리자가
    systemd 와 연동되지 않으면(XFCE 등 흔하다) 부팅해도 그 타깃이 활성화되지
    않아 서비스가 영영 안 뜬다. 실제로 활성 상태인지를 보도록 고쳤다.
    같은 보드의 다른 앱이 .desktop 자동시작을 쓰고 있었던 것도 그 방증이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
2026-08-06 키오스크를 전용 크로미움 프로필로 격리
    키오스크가 뜨긴 하는데 이전에 쓰던 앱의 페이지가 대신 떴다. 공용 프로필을
    쓰면 "이전 세션 복원"이 살아나 예전 키오스크가 보던 주소가 함께 열린다.
    이 보드처럼 다른 키오스크를 돌린 적이 있는 기계에서는 반드시 갈라야 한다.
    --user-data-dir 로 전용 프로필(~/.torus-kiosk-profile)을 쓰고,
    --restore-last-session=false, --no-first-run, --no-default-browser-check 을
    함께 준다. install-kiosk.sh 와 start-all.sh 양쪽에 같은 설정을 넣었다.
    Claude-Session: https://claude.ai/code/se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
2026-08-06 하드웨어 가이드를 실제 구성에 맞춤
    설치 절차가 실물과 어긋나 있었다. 브리지를 systemd 서비스로 적어 두었는데,
    우노 Q 에서는 App Lab 앱으로 돌아야 한다.
    - 부팅 시 뜨는 것이 App Lab(스케치+브리지)과 systemd(웹서버+키오스크)로
    나뉜다는 것을 절로 만들어 앞에 두었다.
    - 키오스크를 서비스로 걸지 .desktop 으로 걸지 정하는 기준과,
    크로미움 프로필을 갈라 쓰는 이유(이전 세션 복원)를 적었다.
    - 의존성 설치를 pip3 에서 apt 로 바꿨다. 이 보드에는 pip3 가 없었다.
    Claude-Session: https://clau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
2026-08-06 게임 구조 v2 — 종류 선택 + 단계×라운드 + 혼합 게임
    기존의 "1차 색깔 → 2차 숫자 → 3차 모양" 순차 코스를 버리고, 시작할 때
    게임 종류를 고르는 구조로 바꿨다.
    - 선택 화면(select.js 신설): 색상·숫자·모양·혼합 4종을 버튼 색으로 고른다
    (빨강=색상, 노랑=숫자, 초록=모양, 파랑=혼합). 카드가 버튼 색으로 크게
    칠해져 있어 "저 색 버튼 = 저 게임"이 설명 없이 보인다. 카드마다 그
    종류의 최고 기록(또는 완주 횟수)을 보여 준다.
    - 진행: 1개 기억부터 4개 기억까지 4단계, 단계마다 5라운드 반복 (총 20라운드
    = 완주). HUD 배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
2026-08-06 선택 카드에 대표 이미지를 넣고 여백을 줄임
    카드 안에 글자 세 줄만 있어서 위아래 여백이 크고, "모양 게임"이 뭔지
    글로만 봐서는 안 와닿는다는 지적이 있었다.
    - 카드마다 그 게임에서 실제로 나오는 것들의 미리보기를 넣었다:
    색상=색칩 4개, 숫자=숫자 4개, 모양=별·하트·달·세모, 혼합=색칩+숫자+모양 섞음.
    빨강 카드 위 빨강 칩처럼 카드와 같은 색인 칩도 보이도록 흰 테를 둘렀다.
    - 제목·설명 글자를 키우고 카드 세로를 48vh → 42vh 로 줄였다.
    수용 체크리스트 16/16, 색상 게임 완주 자동 플레이로 회귀 확인.
    Co-Auth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
2026-08-06 선택 화면의 제목·카드를 아래로 내려 균형을 맞춤
    카드가 위에 붙어 있어 화면 아래가 허전했다. 왼쪽 아래 토러스와
    겹치지 않는 선에서 전체를 내리고 제목과의 간격도 벌렸다.
    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
2026-08-06 선택 카드를 제목과 말풍선 사이 한가운데로
    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
2026-08-06 Pages 재배포 트리거
    fbb9ff5 의 pages build and deployment 가 러너 준비 단계에서 실패했다
    (GitHub 인프라 쪽 일시 장애로 보인다). 내용 변경 없이 배포만 다시 돈다.
    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
2026-08-06 기록을 완주 횟수 하나로 단순화 (부스 운영 전제)
    부스라 매번 다른 사람이 오고, 게임에는 끝(4개 기억 5/5 완주)이 있다.
    그 두 가지를 놓고 보면 "최고 기록" 표시는 성립하지 않는다 — 특정인의
    기록이 아니고, 시작만 해도 "최고 1개 1/5"가 남고, 어차피 며칠이면 만점에
    닿아 영영 안 바뀌는 죽은 숫자가 된다.
    부스에 계속 쌓여서 의미가 있는 숫자는 완주가 몇 번 나왔나 하나뿐이다.
    - storage 를 게임별 완주 횟수만 저장하도록 새로 썼다 (torus-memory.clears.v2)
    - 선택 카드: "지금까지 완주 N번!" / 없으면 "첫 완주에 도전해 봐!"
    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
2026-08-07 App Lab 앱 폴더 복사 스크립트 추가
    두 번째 보드를 설치하면서 긴 경로를 손으로 치다 오타(변수 대소문자,
    firmware/sketch 철자, ~ 뒤 빗금 누락)가 반복됐다. 복사 세 줄을
    스크립트 하나로 묶었다.
    scripts/applab-sync.sh — App Lab 앱 폴더를 알아서 찾아(이름이 다르면
    ~/ArduinoApps 에서 sketch/ 를 가진 최신 폴더) sketch.ino·main.py·app.yaml
    을 저장소 것으로 덮어쓰고, 내용까지 확인한 뒤 다음 할 일을 알려 준다.
    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
2026-08-07 크로미움 번역 팝업 차단
    게임이 한국어 페이지라 브라우저 언어가 영어인 보드에서는 켤 때마다
    "Korean → English?" 번역 막대가 떴다.
    - --disable-features 에 TranslateUI 를 추가 (install-kiosk.sh, start-all.sh)
    - 플래그만으로 안 막히는 크로미움 버전이 있어, 키오스크 전용 프로필의
    Preferences 에 translate.enabled=false 와 한국어 번역 차단을 직접 심는다.
    기존 설정 파일이 있으면 다른 키는 건드리지 않고 값만 고쳐 넣는다.
    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
2026-08-08 스피커 설정 절차를 하드웨어 가이드에 추가
    실물 1대에서 확인한 절차 그대로다. 앱코 SLP20 을 허브에 물렸을 때
    소리가 안 났던 원인이 두 겹이었다 — 뒷면 다이얼(볼륨 겸 전원)이 잠겨
    있었고, USB 오디오 카드(CS201)가 ALSA 단계에서 음소거되어 있었다.
    - §5.6 스피커: wpctl 로 기본 출력 확인 → alsamixer 음소거 해제 →
    alsactl store 로 재부팅 유지. 원인 찾기 사다리(다이얼 → 잡음 여부 →
    음소거 → 모니터 잭 우회)도 적었다.
    - 이 보드에는 pactl 이 없고 PipeWire 라 wpctl 을 쓴다는 것을 명시.
    - 문제 해결 표의 '소리가 안 남' 항목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
2026-08-08 효과음을 다채롭게 — 소리도 정보가 되게
    전부 단음이라 밋밋했고, 특히 한 게임 20라운드 동안 클리어음이 매번 같았다.
    음원 파일 없이 Web Audio 합성으로 다음을 넣었다.
    소리 = 정보 (귀로도 외울 수 있게, 다감각 기억 보조):
    - 숫자 0~9 는 값 그대로 펜타토닉 음계 (0=낮은도 … 9=높은라)
    - 모양 8종은 도형마다 시작음이 다른 "딩-동" 두 음
    - 색은 기존 도·미·솔·도′ 에 옥타브 받침음을 겹쳐 도톰하게
    - 카드 입력음도 누른 칸마다 음이 다르다
    지루함 방지 (부스에 하루 종일 트는 소리다):
    - 라운드 클리어 팡파레 5종이 라운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
2026-09-10 해설사 연수용 AI 브리핑 문서 추가
    내일 해설사들이 바이브코딩으로 각자 아케이드 게임 웹앱을 만든다. 연수 초반에
    각자 AI 에게 붙여 넣을 컨텍스트 문서다. 이 프로젝트에서 실물로 검증하며
    알아낸 것을 전부 담았다 — 같은 벽에 다시 부딪히지 않게 하는 것이 목적이다.
    문서를 사람용 튜토리얼이 아니라 **AI 에게 주는 컨텍스트**로 썼다. 그래서
    확정 사양·통신 규약·금지 사항을 단정형으로 적고, 맨 끝에 AI 행동 지침
    (기획을 먼저 묻기, 키보드로 플레이되게 만들기, npm·CDN 금지 등)을 두었다.
    담은 것:
    - 우노 Q 의 결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
2026-09-11 버튼 연결 표시등을 실제로 보이게 고침
    전시 중에 아케이드 버튼이 안 먹어 원인을 짚어야 했는데, 정작 그걸 알려 주는
    표시등이 쓸모가 없었다. 9px 짜리 점이라 팔 길이에서 안 보였고, 문서에는
    위치가 "오른쪽 아래"로 잘못 적혀 있었다 (실제로는 왼쪽 위다).
    - 점을 clamp(11px,1.6vh,20px) 로 키우고 흰 테를 둘러 배경과 분리했다.
    - 실물 키오스크(localhost)에서 끊긴 동안에는 점이 빨갛게 바뀌고
    "버튼 미연결" 글자까지 띄운다. 그 상황이면 버튼이 안 먹으니 손님도 알아야
    하고 운영자는 원인을 바로 안다. 공개 주소(github.io)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
2026-09-11 브리지가 죽으면 자동으로 되살리는 감시 추가
    부스 운영 중 App Lab 의 브리지 앱이 멈춰 아케이드 버튼만 죽는 일이 있었다.
    게임은 멀쩡히 돌고 키보드도 먹으니 화면상으로는 아무 이상이 없고, App Lab 은
    멈춘 앱을 저절로 되살리지 않는다. 체험객이 버튼을 눌러 보고서야 알 수 있었다.
    scripts/bridge-watch.sh 를 추가하고 install-kiosk.sh 가 함께 등록하게 했다.
    30초마다 8765 를 확인해 닫혀 있으면 브리지를 다시 띄운다.
    되살리는 수단은 알아서 찾는다.
    1. TORUS_BRIDGE_RESTART_CMD (비상 탈출구, setsid 로 떼어낸다)
    2. App Lab 앱 컨테이너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
2026-09-21 플레이 기록과 운영자 화면 추가
    한 달 파일럿에서 "반응이 좋다"는 말은 나왔는데 숫자가 없었다. 몇 판이나
    했는지, 어느 게임이 인기인지, 몇 개 기억에서 다들 죽는지를 알아야 다음에
    무엇을 고칠지 근거로 정할 수 있다.
    js/playlog.js — 판마다 한 줄. 시각·게임·도달 단계/라운드·결과(완주/게임오버/
    중도이탈)·소요 시간·이어하기·오답 횟수. 개인정보 없음, localStorage 에만,
    최대 5,000줄(오래된 것부터 버림). 집계·기간·CSV 는 순수 함수라 node --test
    로 검증한다 (14개 추가, 총 57개).
    js/scenes/admin.js — 타이틀에서 노랑+초록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
2026-09-21 완주 화면에 "당신의 기억폭" 카드 추가
    수학문화관다운 마무리. 이 게임의 최대치 4개가 인지과학이 말하는 작업기억
    용량(코완 2001, '마법의 수 4')과 맞아떨어지므로, 완주를 "사람의 한계까지
    채운 것"으로 해설한다. 칸 4개가 전부 찬 눈금 + 과학 한 줄 + 숫자만 따로
    재면 7±2(밀러 1956)라는 꼬리로 숫자 게임을 권한다. 해설사가 "왜 4개일까요?"
    로 이어갈 거리를 주는 것이 목적이다.
    게임오버에는 넣지 않는다 — 15초 카운트다운 안에 읽기 빠듯하다.
    문구는 strings.js 에, 강조 구절은 innerHTML 없이 텍스트 노드로 쪼개 넣는다.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
2026-09-21 2인 대결(흰색 버튼) + 두 좌석 한 화면 + 라즈베리파이 5 정식 구성
    정식 게임기는 라즈베리파이 한 대가 책상 2대를 맡는다. 모니터 두 대를 3840×1080
    한 창으로 쓰고, 웹앱이 왼쪽 반 = 책상 1, 오른쪽 반 = 책상 2 로 나눠 쓴다.
    좌석(seat) 구조
    main.js 가 좌석마다 씬 자리·상주 요소·입력 허브·소리를 만들고 runApp 을 돌린다.
    style.css 의 vw/vh 를 전부 cqw/cqh(container query 단위)로 바꿔, 좌석이 곧 화면이
    되게 했다 — 좌석이 하나면 예전과 완전히 같다. ?seats=2 또는 가로세로비 2.6 이상이면
    2좌석. 소리는 좌석별 팬(왼쪽 책상 = 왼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
2026-09-21 정식 게임기 책상 제작 도면 추가 (docs/desk.html, 책상도면.pdf)
    800×600×700 원목 책상 + 등판(27" 모니터 VESA 직결, 스피커 그릴, 제어부 하부 박스)
    정면·측면·상판 버튼 위치·버튼 구멍 단면·등판·하부 박스 배면·두 책상 배치·부재표를
    치수 포함 A4 3장으로 정리. README 문서 목록에 추가.
    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
2026-09-21 책상 도면 2판: 스피커 칸 확대, 흰 버튼 분리, 대칭 구조, 뒤 도어
    - 하부 박스 800×250×200 → 800×300×250 (BR-1000A2 150×228×161 이 들어가도록,
    칸 내부 170×264×214). 합판 18mm 로 바꾸고 사각 그릴 120×200.
    - 흰(도전) 버튼을 상판 줄에서 빼서 하부 박스 앞면 가운데(400, 860)로.
    색 버튼 4개는 190/330/470/610 으로 가운데 정렬.
    - 체험방법·체험미션 안내판 삭제.
    - 제어부는 뒤 도어(경첩+캠락)로 열고, 스피커 칸 뒷판은 나사 탈착.
    - Ø30 통로는 마주 보는 옆판에만 1개 (책상 B는 A의 좌우 대칭), Ø25 전원 출구는 A만.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
2026-09-21 책상 도면 3판: 전부 원목, 흰 버튼 상판 뒷줄 구석, 뒷판 전체 문
    - 합판 없이 전부 원목. 하부 박스 판재 20, 800×300×240 (스피커 칸 내부 170×260×200).
    - 흰(도전) 버튼을 다시 상판으로: 뒷줄 오른쪽 구석 (700, 290), 책상 B는 (100, 290).
    - 스피커 그릴은 앞판 사각 110×190 R15 (원형 Ø120+Ø55 대안 명시).
    - 모니터 VESA 볼트는 판 뒤 가로재 700×100×30 에 인서트 너트로.
    - 하부 박스 뒷판 760×260 전체가 아래로 젖혀지는 문 (경첩 2 + 캠락 1), 통풍 Ø12 ×12.
    Claude-Session: https://claude.ai/code/session_01EKXYb7k7QXk6KPT26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
2026-09-21 책상 도면 4판: 판재 30 통일, 살대 그릴(홈 8×150 ×9), 버튼 줄 150/270
    - 원목 두께를 50(각재)/40(상판)/30(판재 전부)로 통일. 등판 판 30 에 VESA 인서트 직접,
    VESA 가로재 삭제.
    - 하부 박스 800×300×260 (판재 30, 스피커 칸 내부 160×240×200, 가운데 360).
    - 스피커 그릴은 천 대신 앞판에 라우터 관통 홈 8×150 ×9줄(간격 20).
    - 색 버튼 앞줄 150, 흰 버튼 뒷줄 270 (박스 깊이 260 에 맞춤).
    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
2026-09-21 책상 도면: 색 버튼 간격 160, 흰 버튼 왼쪽 뒤 구석으로
    - 색 버튼 190/350/510/670 (중심 간격 140 → 160, 플랜지 사이 62).
    - 흰(도전) 버튼 (700, 270) → (100, 270). 책상 B는 전부 좌우 대칭.
    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
2026-09-21 책상 도면: 버튼 줄을 앞으로 (색 120, 흰 240)
    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
2026-09-21 책상 도면: 색 버튼 좌우 전부 160 등간격 (160/320/480/640), 흰 버튼 (100, 260)
    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
2026-09-21 책상 도면 5판: 스피커·제어부를 상판 아래 스커트 박스로
    - 상판 위 박스 제거. 다리 사이 높이 250(410~660) 스커트 박스에 스피커(눕힘)와 제어부.
    - 스피커 눕혀서 앞쪽 양끝, 앞판 살대 그릴 홈 8×200 ×6줄. 제어부는 뒤쪽, 뒷문 전체 젖힘.
    - 등판 판 700×870×30 한 장, 기둥 앞면 맞춤으로 판 뒤 20 틈에 케이블, 상판 Ø20 구멍.
    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
2026-09-21 책상 도면: 모니터 중심 1,150 으로, 스피커 뒤 50 여유
    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
2026-09-21 책상 도면: 등판 1,430 으로 낮춤 (모니터 중심 1,100), 앞 바닥판 탈착으로 버튼 결선 접근
    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
2026-09-21 책상 도면: 버튼 밑 간섭 검토 추가, 흰 버튼 X 100 → 120 (스커트 옆판 회피)
    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
2026-09-21 책상 도면 검토 반영: 케이블 경로(뒤 가로재 Ø30), 스피커 위치, 바닥판 받침, 버튼 실물 치수
    - 등판 뒤 20 틈 + 상판 Ø20 안은 뒷문과 겹치고 플러그가 못 지나가서 삭제.
    기둥 가운데 홈, 케이블은 판 뒤로 내려와 고정 뒤 가로재(700×40×30)의 Ø30 가로 구멍으로.
    - 스피커가 옆판(50~80)과 겹치던 것을 x 80~308 / 492~720 으로, 그릴 중심 194/606.
    - 앞 바닥판 640×270: 앞 받침 각재 + 가로 각재(스토퍼 겸)에 노브 4개. 뒤 바닥 640×270 고정.
    - 뒷문 700×210, 상판 뒤 모서리 기둥 노치 2, 버튼 실물 치수(Ø98·몸통 23·스템 27) 반영.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
2026-09-21 책상 도면: 버튼 스템 실측 23 → Ø25 관통 확정
    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
2026-09-22 책상 도면: 옆판 통로·전원 출구 삭제, 모든 선은 뒤 가로재 Ø40 구멍 하나로
    두 책상 사이 선은 뒤에서 돌아 들어가므로 옆판에 구멍이 없고,
    A·B 가 흰 버튼 자리만 다른 같은 구조가 된다. 뒤 가로재 60, 뒷문 200.
    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
2026-09-22 책상 도면: 앞 칸 → 제어부 선 통로(가로 각재 위 개방) 표시
    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
2026-09-22 책상 도면 최종본: 겨냥도 3종, 가공 체크리스트, 배선도 추가, 6쪽으로 재배치
    - 등각 투영 겨냥도(앞·오른쪽 / 뒤·왼쪽 / 두 대 나란히)를 의존성 없는 SVG로 생성.
    - 사장님용 가공 체크리스트(구멍·홈·인서트 위치 한 표).
    - 배선도: 두 책상 평면 + 세로 단면 + 선 목록(경로·구멍·길이).
    - 확정 목록을 사장님/우리 쪽으로 분리. 쪽 넘침 없이 A4 6쪽.
    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
2026-09-22 책상 도면: 멀티탭 6구 (콘센트 5개 사용) 로 정정
    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
2026-09-22 한 장짜리 게임 소개 PDF 추가 (docs/intro.html, 게임소개.pdf)
    실제 게임 화면 캡처 5장(선택·외우기·따라 누르기·완주·도전)과 큰 글씨 설명, A4 가로 1장.
    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
2026-09-22 책상 도면: 수종 반영 — 상판·다리·등판 소나무, 스커트 박스 오동나무 (그림 색·범례·메모)
    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
2026-09-22 책상 도면: 수종 메모 추가 후 6쪽 안에 들어가게 그림 축소
    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
2026-09-22 책상 도면: 오동나무가 더 짙다는 사장님 말에 맞춰 색 뒤집음 (소나무 크림, 오동 회갈)
    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
2026-10-24 인코더 배선 확인 페이지 추가 (docs/buttontest.html)
    누른 버튼이 어느 책상 어느 색으로 잡히는지 불로 보여 준다. 배정 안 된 번호는 경고.
    파이 설치 문서 §5 와 README 에 링크.
    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
2026-10-24 벤치 조립 가이드 추가 (docs/assembly.html, 조립가이드.pdf)
    파이 5 단자 자리, 케이스·써멀패드, 1차 연결(모니터 1대), 전체 연결 블록도,
    버튼 하나의 스위치(COM/NO)·LED 배선, 12V 단자대 — A4 가로 2장.
    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
2026-10-24 파이 키오스크: 패널 내리고 크로미움을 맨 위 층으로, bridge=0 으로 '버튼 미연결' 표시 제거
    첫 실기 부팅에서 작업 표시줄·알림 풍선이 게임 위에 남고 브리지 상태 점이 떴다.
    pi-kiosk.sh 가 lxpanel 을 내리고, Openbox 규칙에 layer=above·focus 추가, URL 에 bridge=0.
    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
2026-10-24 파이 키오스크: 작업 표시줄을 세션 autostart 에서 제거 (pkill 은 '@' 자동 재시작으로 무효)
    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
2026-10-24 파이 키오스크: lxsession 세션 이름(rpd-x 등)을 자동 감지해 패널 autostart 제거
    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
2026-10-24 파이 키오스크: 떠 있는 openbox 의 --config-file 을 읽어 그 파일에 창 규칙을 넣는다 (rpd-rc.xml)
    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
2026-10-24 파이 키오스크: 창이 뜬 뒤 xdotool 로 0,0 3840×1080 을 다시 박는다 (크로미움의 모니터 크기 클램프 우회)
    Openbox 규칙에 monitor=1 을 명시해 왼쪽 모니터 기준 0,0 으로.
    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
2026-10-26 파이: 외부 전원 버튼 지원 — 전원 키를 바로 poweroff 로 (pwrkey 대화상자 끔, logind 설정), 문서 7-2
    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
2026-10-26 파이 키오스크: Openbox 단축키 (Ctrl+Alt+T 터미널, Ctrl+Alt+Q 게임 닫기, Ctrl+Alt+G 다시)
    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
2026-10-28 전원 버튼 배선도 추가 (docs/powerbutton.html, 전원버튼배선.pdf) — 파이 5 J2 위치·연결·대안
    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
2026-10-28 전원 버튼 배선도: 한 장에 맞게 배치 정리
    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
2026-10-28 키 확인 페이지 추가 (docs/keytest.html) — 키보드가 보내는 key/code 를 크게 표시
    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
2026-10-28 파이 키오스크: 창 크기 고정 뒤 게임 창에 키보드 포커스를 준다
    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
2026-10-28 파이 키오스크: 스크린 리더(orca) 제거 — 숫자 키를 가로채 게임 입력이 안 되던 원인
    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
2026-10-30 인코더 번호표 덮어쓰기 (?pad= / TORUS_PAD) — 기판 핀이 죽었을 때 선만 옆 자리로 옮기고 번호를 바꾼다
    파이 설치 첫 책상에서 K1 핀이 죽어 빨강이 안 먹었다. 기기별 설정은 ~/.config/torus/kiosk.env
    에 두어 git pull 에 영향받지 않게 한다. 형식 오류는 무시하고 기본 번호표 사용.
    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
2026-10-30 어트랙트(시연) 모드는 소리 없이 돈다 — 사람이 깨우면 원래대로
    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
2026-10-30 파이 키오스크: kiosk.env 를 source 하지 않고 글자로 읽는다 (값의 ';' 가 명령 구분자로 먹혀 번호표가 잘리던 버그), 띄우기 전 브라우저 캐시 비움
    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
2026-10-31 버튼 용도 안내 — 타이틀 화면 그림 범례(두 좌석일 때) + 책상에 붙이는 인쇄 라벨
    이용자가 흰 버튼(도전)과 빨강+파랑 2초(처음으로)를 몰라 못 쓰는 일이 있어서,
    실물 게임기 타이틀에는 키보드 힌트 대신 색 점 범례를 띄우고, 코팅해 붙일 라벨 시트를 추가.
    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
2026-10-31 버튼 안내 라벨: 줄바꿈 없게 문구·그림 크기 조정
    - '처음으로' 라벨 문구를 세 줄로 정리하고 nowrap 적용
    - 빨강+파랑 그림 폭 130으로 줄여 글자 공간 확보
    - '흰 버튼 = 도전!' 문구도 짧게
    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
2026-10-31 버튼 안내 라벨: 이사만루체 적용
    - 이사만루체(GongGothic Light/Medium/Bold) woff 를 docs/fonts 에 동봉 (오프라인 동작)
    - labels.html 본문·SVG 글자 모두 esamanru 로, 제목 700 / 본문 500
    - docs/fonts/README.md 에 출처·라이선스 기록
    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
